juchong/ProtoRIO/ProtoRIOControl/ProtoRIOControl.UWP/Assets/LargeTile.scale-100.png

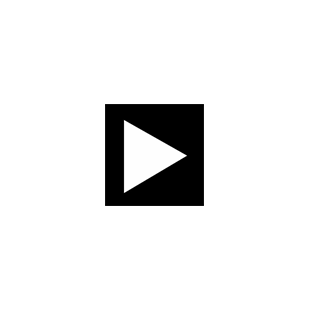
ProtoRIOControl/ProtoRIOControl.UWP/Assets/LargeTile.scale-100.png
