juchong/ProtoRIO/ProtoRIOControl/ProtoRIOControl.UWP/Assets/SmallTile.scale-200.png

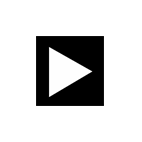
ProtoRIOControl/ProtoRIOControl.UWP/Assets/SmallTile.scale-200.png
