juchong/ProtoRIO/(threads)

Thread 1 (2018-10-01):

Wire.requestFrom() should not be followed by Wire.endTransmission().

Koepel, 2018-10-01:
In the file "ProtoRIO/ProtoRIO-Leonardo-Firmware/ProtoRio1p1BTLE/LTC2947.ino" you may remove the `Wire.endTransmission()` that are at the moment at line 98, 111, 126.
Explanation: [Common-mistakes#2](https://github.com/Koepel/How-to-use-the-Arduino-Wire-library/wiki/Common-mistakes#2)
