juchong/ProtoRIO/Schematic-PCB/ProtoRIO RevB_PCB.pdf

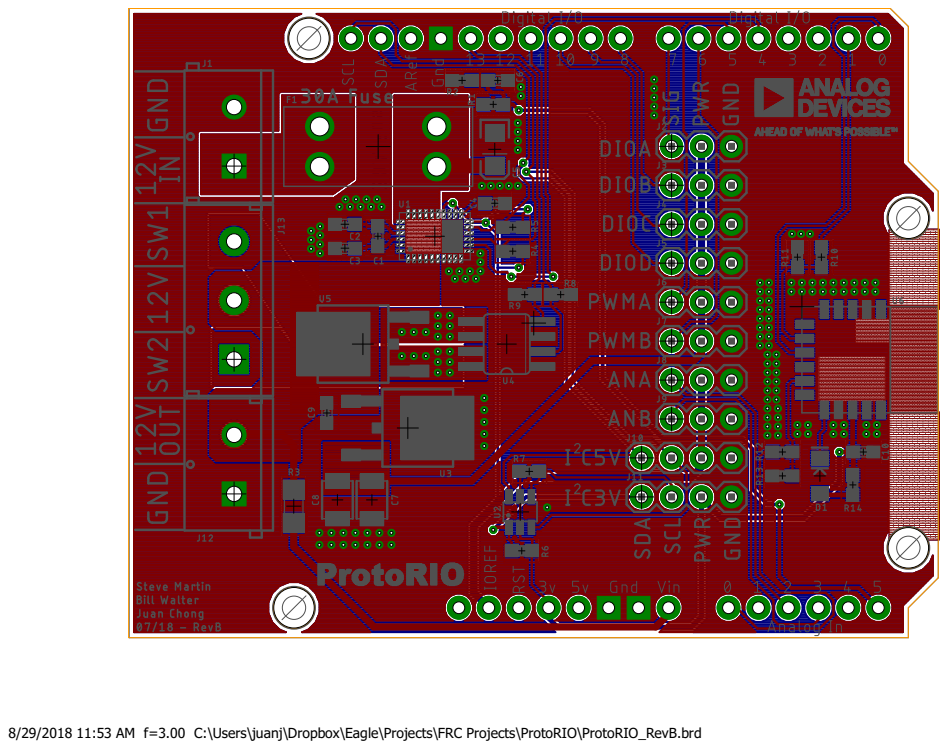
[picture p31: page 1]

8/29/2018 11:53 AM f=3.00 C:\Users\juanj\Dropbox\Eagle\Projects\FRC Projects\ProtoRIO\ProtoRIO_RevB.brd
