juchong/ProtoRIO/Schematic-PCB/ProtoRIO RevB_SCH.pdf

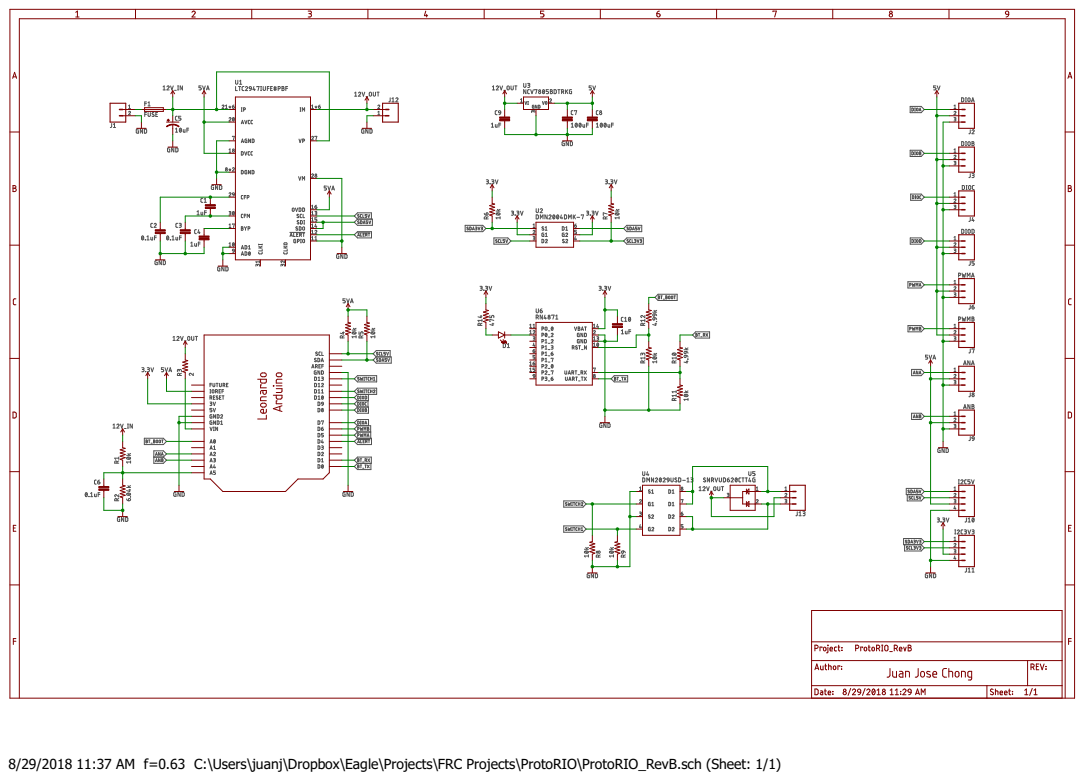
[picture p32: page 1]

8/29/2018 11:37 AM f=0.63 C:\Users\juanj\Dropbox\Eagle\Projects\FRC Projects\ProtoRIO\ProtoRIO_RevB.sch (Sheet: 1/1)
