juchong/ProtoRIO/(commit log)

2018-07-26 Working on status and PWM UI
2018-07-30 Added UI for sensors and pneumatics.
2018-07-31 callback methods no longer fired on main thread to fix issues with scanning and navigating at the same time.
2018-07-31 Fixed bluetooth connect. Added bluetooth disconnect. All dialogs switched over to UserDialogs library
2018-07-31 Updated sensor page UI
2018-07-31 Added option to cancel bt connect. Battery data from ProtoRIO parsed and displayed
2018-08-01 Fixed some android bt bugs. Changed color scheme to ADI colors. Colors stored in app resources. Added read request timer.
2018-08-02 Added PWM mode buttons
2018-08-02 Removed servo mode stuff b/c ProtoRIO does not appear to handle it differently.
2018-08-02 Added solenoid control
2018-08-02 Added sensors to data class
2018-08-02 Sensors page works. Fixed android bug with labels loosing text alignment when updated off the screen.
2018-08-06 Added sensor connection info label
2018-08-07 Fixed device selector padding on iOS. Fixed sensors not disabling on disconnect
2018-08-29 Added design files to repository
    [ProtoRIO_RevB_BOM.csv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]
2018-08-29 Changed vias to be covered
    [BottomCopper.gbl, BottomSolderMask.gbs, TopCopper.gtl, TopSolderMask.gts]
2018-10-29 Updated WiFi scanning to only list ProtoRIO devices when stopped Edited Pneumatic text to indicate SW1&2 instead of A&B Added connection information for Pneumatics
2018-11-23 Added motor control with limit stops (encoder, switch and POT) Backward compatible, just adds more functionality. New Android App developed to take advantage of limit stops.
2018-11-23 Initial version of MIT App Inventor motor control App with limit stops (encoder, switch and POT limits). Requires latest version of Arduino SW
2018-12-19 Initial Motor Control Application with limit stops
